sgmk/FM-1-Parametric-Vintage-Case-for-Lasercutting/docs/ACOUSTICS_AND_RESONATOR_PLAN.md

# Acoustic & Sub-Bass Resonator Guide — M-VAVE FM-1 Vintage Case

> **How this guide is organized:**
> * **This document (`ACOUSTICS_AND_RESONATOR_PLAN.md`)** is a **clear, visual guide** explaining how the speakers, clamps, and resonators work, covering our recommended build (**Aperiodic Variovent + 3D Spider Bridge Clamp**) as well as the tuned Helmholtz bass-reflex option.
> * **Want the hard-hitting peer-review engineering audit & hackerspace debate?**
>   👉 Read [**`PEER_REVIEW_DIALOGUE_SYNTH_GEEK_VS_SOUND_ENG.md`**](PEER_REVIEW_DIALOGUE_SYNTH_GEEK_VS_SOUND_ENG.md) — Dr. Viktor Vance ("The Baffle Butcher") vs Maker/Synth Geek on parasitic leaks, acoustic inertance, and mechanical clamping.
> * **Want the full story & workbench listening tests in magazine format?**
>   👉 Read [**`SYNTH_JOURNALIST_EDITORIAL_OVERVIEW.md`**](SYNTH_JOURNALIST_EDITORIAL_OVERVIEW.md) — Sound On Sound / CDM style deep-dive feature article.
> * **Want the full raw math, Thiele-Small tables, differential equations, and nomographs?**
>   👉 Jump to [**`ACOUSTICS_DEEP_ENGINEERING_ANALYSIS.md`**](ACOUSTICS_DEEP_ENGINEERING_ANALYSIS.md).

| Chosen Speaker: AliExpress `40 × 22 mm` (`4Ω 5W`) | Alternative Big Speaker: `50 × 31 mm` (`Ø45 mm` Magnet) | 4-Panel Acoustic Audit & Spider Clamp Map |
| :---: | :---: | :---: |
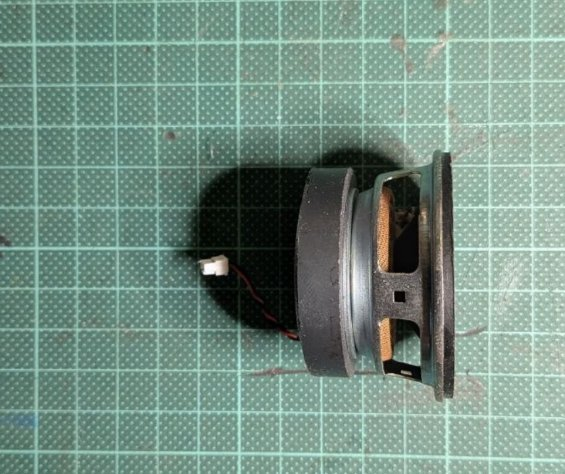
[picture p22: photos/speaker_50mm_side.jpg]
50mm Speaker Side Profile
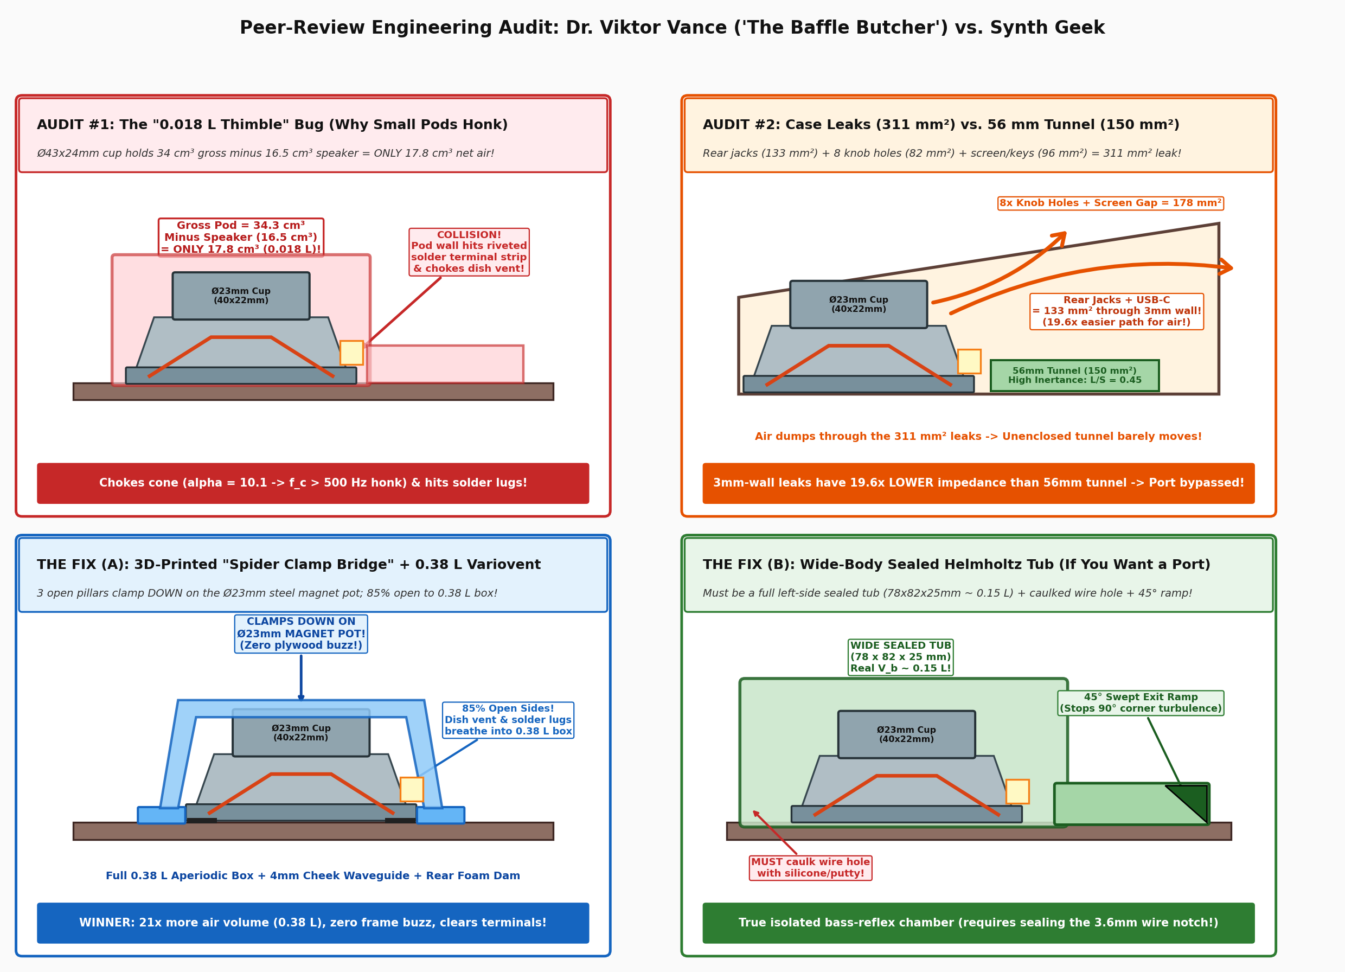
[picture p23: docs/acoustics/viktor_audit_and_spider_clamp.png]
Acoustic Audit & Spider Clamp
| 40mm AliExpress Speaker |  |  |

---

## 1. Recommended Setup: Full-Case Aperiodic Variovent + Downward Clamping

Following the critical peer-review audit by Dr. Viktor Vance, our primary recommended build (`highVintage` preset in [`fm1_lasercut_case.scad`](../fm1_lasercut_case.scad)) uses:
* **Speaker:** **AliExpress `40 × 22 mm` (`4Ω 5W`, `Ø23 mm` shielded steel cup)** mounted face-down on the Bottom Panel at **`[X = 38 mm, Y = 64 mm]`** over the curved pinwheel grille with a `1.5 mm` EVA foam sealing gasket.
* **Acoustic Enclosure Principle:** **Aperiodic Variovent (`~0.38 L` Sub-PCB Cavity).**
  * Rather than fighting the unavoidable `~311 mm²` of parasitic case leaks (jacks, USB-C, power slider, encoder shafts), we turn the entire interior into an **aperiodic damped flow enclosure**.
  * By placing a loose `2–3g` pinch of polyfill or felt around the speaker inside the case, the system acts as a mechanical-acoustic damper, achieving **$Q_{tc} \approx 0.68$**. This delivers flat, punchy, uncolored synth bass down to **`~125 Hz`**, eliminates cone bottoming/unloading on sub-audio FM clicks, and has **zero port wind noise (chuffing)**.
* **Mechanical Clamping:** To prevent plywood buzz at the full `1.35 W` amplifier output, the speaker must be held down under mechanical compression, not just located by a loose ring.

### Four Ways to Build It in OpenSCAD (`resonator_type` Dropdown)
Selectable right in [`fm1_lasercut_case.scad`](../fm1_lasercut_case.scad) under `/* [Speaker & Acoustic Grille] */`:

| Build Method | `resonator_type` Setting | How to Export & Assemble |
| :--- | :--- | :--- |
| **Option 1 (100% Laser-Cut Bass-Reflex): Stacked Wood Helmholtz Tunnel** | `"helmholtz_laser_duct"` *(Default)* | 1. Set `resonator_type = "helmholtz_laser_duct"` and `part_to_show = "layout"`.<br>2. Automatically adds the 3 wooden resonator pieces to the laser sheet (**2× Tunnel Wall Layers** + **1× Tunnel Roof Plate**).<br>3. Bottom plate gets the exit vent! Glue the layers together onto the inside of the Bottom Panel. (Export standalone via `part_to_show = "helmholtz_laser"`). |
| **Option 2 (3D-Printed Sealed Bass-Reflex): Wide-Body Sealed Tub + $45^\circ$ Ramp** | `"helmholtz_3d_pod"` | 1. Set `resonator_type = "helmholtz_3d_pod"` and `part_to_show = "helmholtz_pod"` → **Export as STL**.<br>2. A wide-body sealed chamber ($V_b \approx 0.15\,\text{L}$) with terminal relief pockets and a $45^\circ$ deflector ramp out the bottom panel.<br>3. Must be sealed airtight to the bottom plate using silicone or closed-cell foam tape! |
| **Option 3 (100% Laser-Cut Clamped Retainer): 2-Layer Stepped Wood Clamp** | `"stepped_clamp_laser"` | 1. Set `resonator_type = "stepped_clamp_laser"` and `part_to_show = "layout"`.<br>2. Cut the two stacked wooden rings: **Layer 1** centers the $\varnothing 40.4\,\text{mm}$ rim; **Layer 2** overhangs the outer metal flange by $1.2\,\text{mm}$ with a $100^\circ$ terminal cutout.<br>3. Screw or glue down to clamp the outer flange against the bottom gasket. (Export standalone via `part_to_show = "stepped_clamp"`). |
| **Option 4 (3D-Printed Bridge Clamp): 3-Pillar Spider Clamp Bridge** | `"spider_clamp_3d"` | 1. Set `part_to_show = "spider_clamp"` → **Export as STL** and 3D-print in PETG or PLA.<br>2. Fits over the `40 mm` driver with an open 3-pillar bridge, clearing the fragile side solder terminals by $100^\circ$.<br>3. Fasten down with 3× M2.5 wood screws to press down on the $\varnothing 23\,\text{mm}$ magnet pot with an EVA foam cushion. |

---

## 2. Beginner's Visual Guide: How Speakers & Sub-Bass Resonators Work

Why do we need a sealed ring, a Helmholtz tunnel, or a passive radiator in the first place? Look at the 4 panels below:

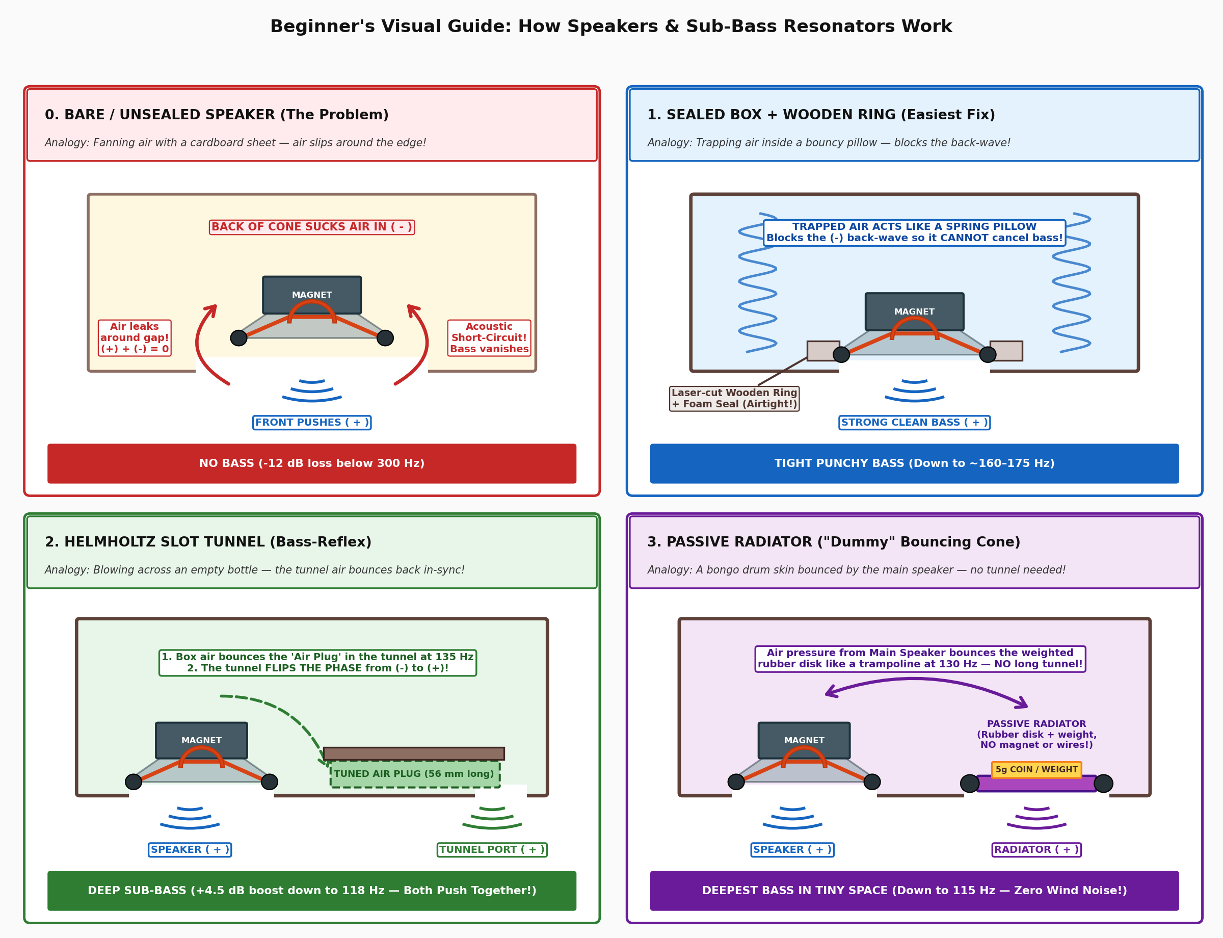
[picture p24: docs/acoustics/beginner_resonators_explained.png]
Beginner's Visual Guide: How Speakers & Sub-Bass Resonators Work


### Panel 0: Bare / Unsealed Speaker ("Acoustic Short-Circuit" — Why Bass Vanishes)
* **Analogy:** Fanning yourself with a piece of cardboard that has a hole in the middle — air just slips around the edge instead of blowing forward.
* **What happens:** When the speaker cone pushes down (`+`), the back of the cone sucks air in (`-`). If the speaker rim isn't sealed to the bottom panel, that `-` suction wave loops around the rim and cancels the `+` wave (`+` meets `-` = **zero bass below `300 Hz`**).
* *(Formula & graph: [Deep Analysis §3.1 — Acoustic Dipole Short-Circuit](ACOUSTICS_DEEP_ENGINEERING_ANALYSIS.md#31-acoustic-dipole-short-circuit-unbaffled-driver)).*

### Panel 1: Sealed Box + Wooden Ring ("The Bouncy Air Pillow" — Easiest Fix)
* **Analogy:** Putting your thumb over the nozzle of a bicycle pump — the trapped air acts like a springy cushion.
* **What happens:** Gluing the laser-cut wooden ring (`resonator_type = "retainer_ring"`) + thin foam tape around the speaker rim traps the `-` back-wave inside the box so it **cannot** leak out and cancel your bass.
* **Result:** Tight, punchy synth bass down to **`~160–175 Hz`**, boosting bass by **`+10 to +14 dB`** over an unsealed speaker.
* **Two Levels of "Simple Sealed Box" Inside Our FM-1 Case:**

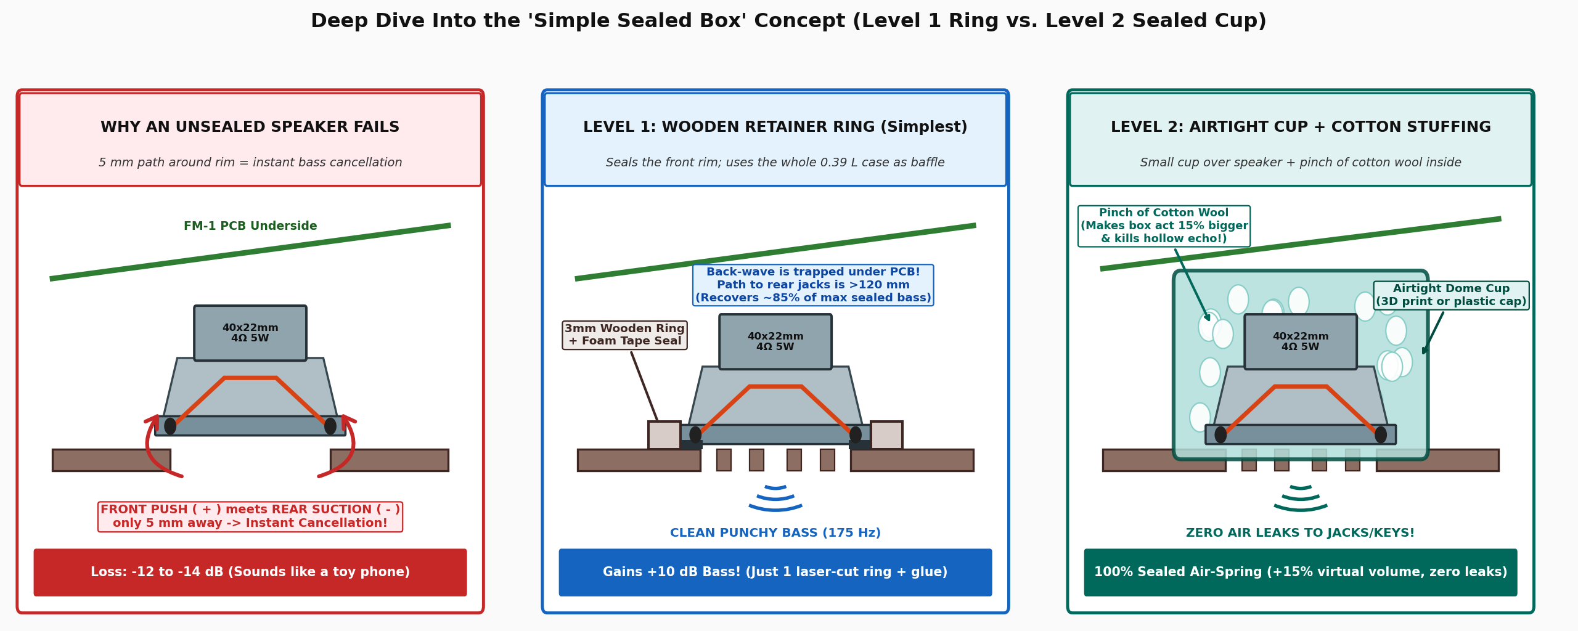
[picture p25: docs/acoustics/sealed_box_explained_detail.png]
Deep Dive Into the Simple Sealed Box Concept


  1. **Level 1 — Just the Laser-Cut Wooden Ring (`resonator_type = "retainer_ring"`):**
     * Seals the **front rim** of the speaker to the Bottom Panel, while using the **entire `0.39 L` wooden case** under the PCB as the rear chamber.
     * Even though the outer wooden case isn't 100% airtight (air can slowly breathe out through the rear USB-C/Audio jack cutouts or silicone button gaps `120 mm` away), sealing the front rim stretches the cancellation path from `5 mm` to `>120 mm` — recovering **`~85%` of the bass (`+10 dB`)** with just 1 laser-cut ring!
     * **Bonus with the AliExpress `40 × 22 mm` speaker:** Its galvanized steel basket is shaped like a semi-enclosed dish shroud with only a narrow felt-damped ring vent, so it already acts like a partially self-enclosed driver!
  2. **Level 2 — True 100% Airtight Cup + Cotton Stuffing:**
     * Instead of trying to caulk every wooden finger-joint and jack hole of the whole synth case, you glue a small **`Ø48 × 25 mm` airtight cup** (3D-printed dome, or even a plastic pill bottle cap / PVC end-cap) right over the back of the speaker on the Bottom Panel.
     * **The Cotton Wool Trick:** Loosely placing a **fluffy pinch of cotton wool or pillow stuffing (`~1 gram`)** inside that cup slows down the air molecules and absorbs heat as the air compresses, making the speaker think the cup is **`15–20%` larger** than it physically is while killing hollow plastic midrange echoes!
* *(Formula & graph: [Deep Analysis §3.2 — Closed-Box Transfer Function](ACOUSTICS_DEEP_ENGINEERING_ANALYSIS.md#32-closed-box-sealed-air-suspension-transfer-function)).*

### Panel 2: Helmholtz Slot Tunnel ("Blowing Across a Bottle" — Our Chosen Build!)
* **Analogy:** Blowing across the top of an empty glass bottle to make a loud, deep `"WHOOOO"` bass note.
* **What happens:** The air inside the speaker chamber acts like a **spring**, and the `56 mm` plug of air sitting inside the narrow `25 × 6 mm` tunnel acts like a **weight**. When the speaker plays bass notes around **`135 Hz`**, the plug of air in the tunnel bounces wildly and **flips the phase of the rear wave from `(-)` to `(+)`**!
* **Result:** Both the speaker cone AND the tunnel exit port push `+` air out of the bottom panel at the same time — adding **`+4.5 dB` of sub-bass** and extending low notes down to **`118 Hz`**.
* *(Formula & nomograph: [Deep Analysis §4 — Helmholtz Port Derivations](ACOUSTICS_DEEP_ENGINEERING_ANALYSIS.md#4-helmholtz-bass-reflex-port-derivations--tuning-nomograph)).*

### Panel 3: Passive Radiator ("The Sympathetic Bongo Drum" — No Tunnel Needed)
* **Analogy:** A sealed drum with two skins — hitting Skin #1 uses internal air pressure to bounce Skin #2 automatically.
* **What happens:** Instead of a `56 mm` air tunnel, you mount a **flat weighted rubber membrane** (a `Ø40 mm` speaker cone with a `5g` coin/washer weight and **no magnet or wires**) in the empty **Rear-Right spot (`[X=126, Y=68]`)** behind the battery. The main speaker's air pressure bounces that rubber disk at `130 Hz` in-sync (`+` + `+`).
* **Result:** Reaches **`115 Hz`** with **zero tunnel space** and **zero wind noise**.
* *(Formula & schematic: [Deep Analysis §7.2 — Hybrid Concept 3](ACOUSTICS_DEEP_ENGINEERING_ANALYSIS.md#72-hybrid-3d-printed--laser-cut-concepts)).*

### Where Each Option Fits on the FM-1 Bottom Panel
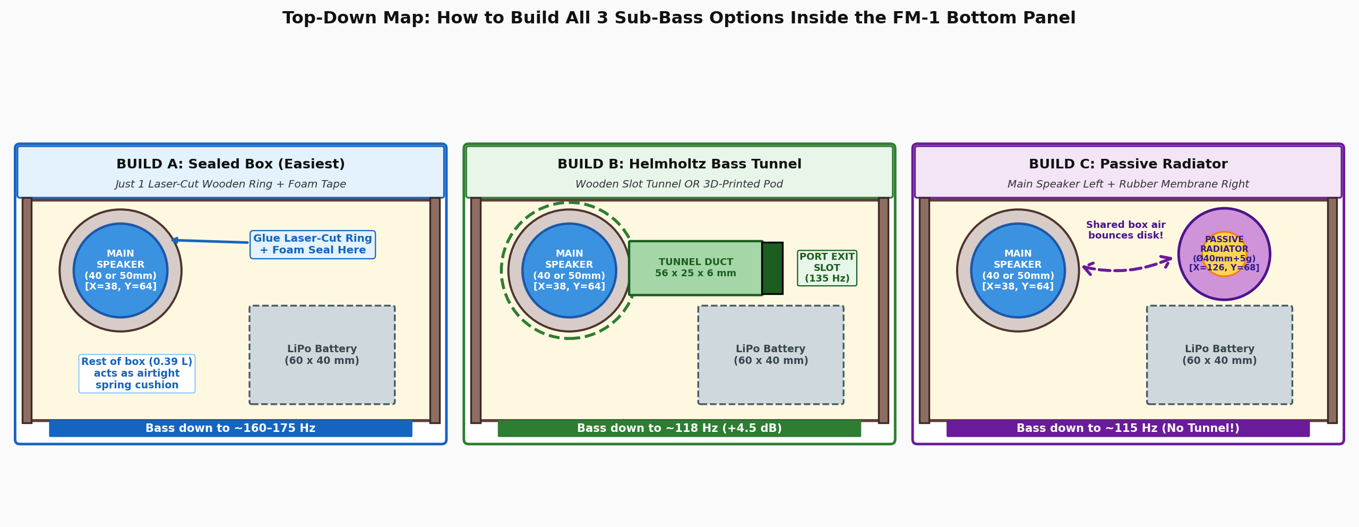
[picture p26: docs/acoustics/beginner_3_builds_inside_fm1.png]
Top-Down Map: How to Build All 3 Sub-Bass Options Inside the FM-1 Bottom Panel


---

## 3. How the Wooden Case Shape & "Cheek Tunnel" Boost the Sound

Our case (`170 × 98.4 mm`, tilted at **`12°`**) has two built-in acoustic advantages:

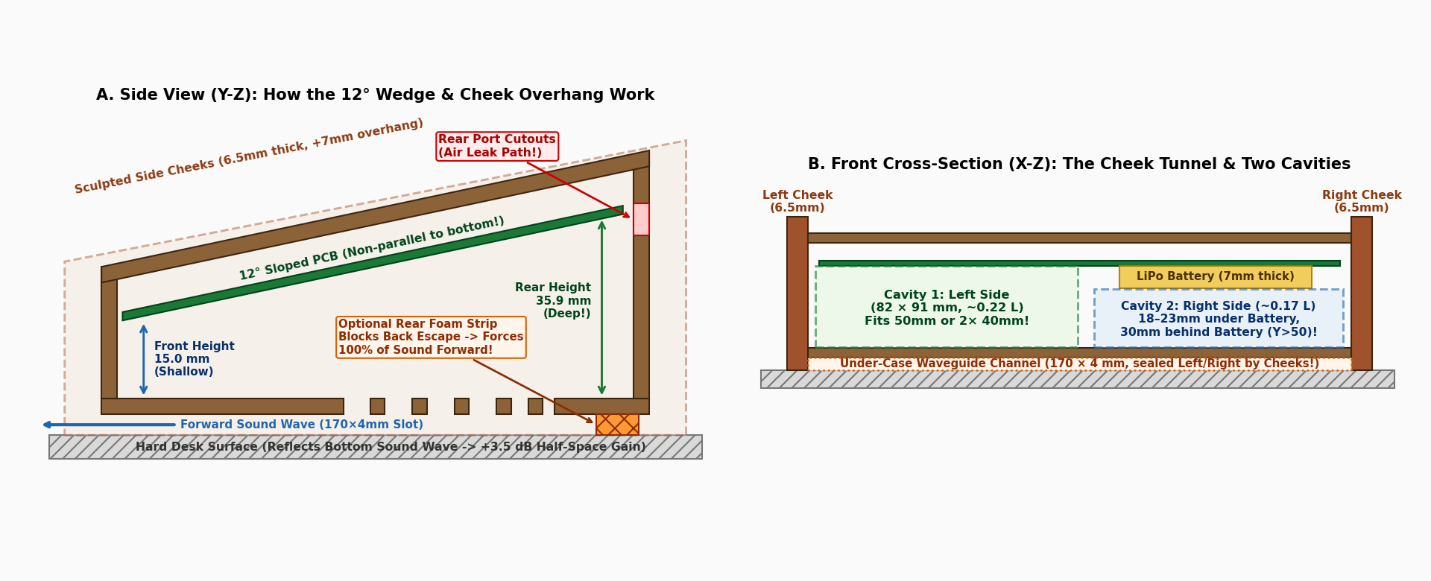
[picture p27: docs/acoustics/current_case_wedge_acoustics.png]
Current Case Wedge & Cheek Tunnel Acoustics


1. **The `12°` Tilted Wedge Stops "Boxy" Echoes:**
   * Inside the case, the space under the PCB grows from `15 mm` at the front keys to `35.9 mm` at the back knobs. Because the PCB and Bottom Panel are **not parallel**, midrange sound waves bounce diagonally instead of slapping straight up and down.
2. **Two Empty Rear Pockets (`[38, 64]` & `[126, 68]`):**
   * The `60 × 40 mm` LiPo battery sits on the front-right, leaving **two `30 mm` deep pockets at the back**: **Rear-Left (`[38, 64]`)** for our main speaker, and **Rear-Right (`[126, 68]`, behind the battery)** for our Helmholtz tunnel exit (or a second speaker / passive radiator).
3. **The 10-Second "Cheek Tunnel" Megaphone Trick:**
   * The left and right wooden side cheeks lift the Bottom Panel **`4.0 mm` off the table**, forming a `170 × 4 mm` tunnel under the synth.
   * **Do this on every build:** Stick a **`170 × 8 × 4 mm` strip of foam or wood** along the **rear bottom edge** between the two cheeks (orange block in Figure A above). That blocks sound from escaping out the back and bounces **100% of the speaker + Helmholtz port sound forward toward your ears**!
   * *(Full geometry math: [Deep Analysis §1 — Enclosure Geometry & Boundary-Waveguide Physics](ACOUSTICS_DEEP_ENGINEERING_ANALYSIS.md#1-enclosure-geometry--boundary-waveguide-physics-12-wedge--cheek-tunnel)).*

---

## 4. Other Ideas Worth Knowing (50mm Speaker, Dual Speakers & 2-Way Tweeter)

If you ever want to experiment beyond the single `40 × 22 mm` + Helmholtz setup, here are the key findings from our engineering analysis:

| Idea | How It Works | What You Need to Know | Deep Analysis Link |
| :--- | :--- | :--- | :---: |
| **1. Using Your Bigger `50 × 31 mm` Speaker** | Moves `3.3×` more air than stock (`12.6 cm²` cone), deepest natural bass ($f_s \approx 145\,\text{Hz}$). | At `31 mm` tall, it is `2 mm` too tall for the `25 mm` case at `[38, 64]`. Either set `case_internal_height = 29` in OpenSCAD, **OR** set `speaker_z_offset = -3` with `speaker_grille_style = "open_hole"` so it drops `3 mm` into the bottom panel. | [Deep Analysis §2](ACOUSTICS_DEEP_ENGINEERING_ANALYSIS.md#2-driver-specifications-measured-vs-estimated-thiele-small-parameters) & [§6](ACOUSTICS_DEEP_ENGINEERING_ANALYSIS.md#6-sub-pcb-3d-obstacle-clearance-map--case-height-scaling) |
| **2. Dual `2× 40 × 22 mm` Speakers (Left + Right)** | Mounts Speaker #1 at Rear-Left `[38, 65]` and Speaker #2 at Rear-Right `[126, 68]` (behind the battery). | Two `40 mm` speakers have **$28\%$ MORE cone area (`16.1 cm²`) than a single `50 mm` speaker**, and both fit inside the slim `25 mm` case! Wire two **`8 Ω`** drivers in **parallel** (`= 4 Ω`) or two **`4 Ω`** drivers in **series** (`= 8 Ω`). | [Deep Analysis §5.1](ACOUSTICS_DEEP_ENGINEERING_ANALYSIS.md#51-mutual-acoustic-coupling-of-two-40--22-mm-drivers) |
| **3. Zero-Cost "Woofer + Tweeter" (2-Way)** | Reuses the tiny **`26.5 mm` stock FM-1 speaker** you removed! Mount it at Front-Left `[25, 21]` wired in parallel through a **`6.8 µF` capacitor**. | Bottom-firing speakers muffle high notes (`>4 kHz`) against the desk. The `6.8 µF` capacitor blocks bass from the tiny stock speaker so it acts as a dedicated **tweeter** for sparkling FM bells while your `40 mm` speaker plays the bass! | [Deep Analysis §5.2](ACOUSTICS_DEEP_ENGINEERING_ANALYSIS.md#52-first-order-capacitive-high-pass-crossover-for-stock-265-mm-tweeter) |
| **4. Four 3D-Printed Hybrid Upgrades** | 1. Airtight Pod + Flared Port (`helmholtz_3d_pod`)<br>2. `12°` Wedge Baffle Cradle for `50 mm` speaker<br>3. TPU Passive Radiator Membrane<br>4. Under-Slung Exponential Horn Plinth | All 4 cross-sections and equations are detailed in the engineering reference. | [Deep Analysis §7.2](ACOUSTICS_DEEP_ENGINEERING_ANALYSIS.md#72-hybrid-3d-printed--laser-cut-concepts) |

---

## 5. Complete Index of Engineering Diagrams & Reference Docs

* **Hard-Hitting Peer-Review Audit Dialogue:** [**`docs/PEER_REVIEW_DIALOGUE_SYNTH_GEEK_VS_SOUND_ENG.md`**](PEER_REVIEW_DIALOGUE_SYNTH_GEEK_VS_SOUND_ENG.md) — Dr. Viktor Vance ("The Baffle Butcher") vs Maker / Synth Geek.
* **Editorial Synth Journalist Overview:** [**`docs/SYNTH_JOURNALIST_EDITORIAL_OVERVIEW.md`**](SYNTH_JOURNALIST_EDITORIAL_OVERVIEW.md) — Feature article on the transformation, audit, aperiodic epiphany, and workbench listening tests.
* **Full Engineering Reference Document:** [**`docs/ACOUSTICS_DEEP_ENGINEERING_ANALYSIS.md`**](ACOUSTICS_DEEP_ENGINEERING_ANALYSIS.md) — Comprehensive derivations, Thiele-Small formulas, and acoustic boundary physics.
* **Visual Diagrams in `docs/acoustics/`:**
  1. [`viktor_audit_and_spider_clamp.png`](acoustics/viktor_audit_and_spider_clamp.png) — 4-panel visual audit diagram: Thimble pod vs real volume, parasitic case leaks vs tunnel inertance, 3D Spider Bridge Clamp, and wide-body Helmholtz tub.
  2. [`beginner_resonators_explained.png`](acoustics/beginner_resonators_explained.png) — 4-panel beginner cartoon explaining Unsealed vs. Sealed vs. Helmholtz Tunnel vs. Passive Radiator.
  3. [`beginner_3_builds_inside_fm1.png`](acoustics/beginner_3_builds_inside_fm1.png) — Top-down map of the 3 sub-bass builds inside the FM-1 bottom plate.
  4. [`current_case_wedge_acoustics.png`](acoustics/current_case_wedge_acoustics.png) — Cross-sections of the `12°` wedge enclosure, internal cavities, and under-case "cheek tunnel" + rear foam dam.
  5. [`spl_frequency_response.png`](acoustics/spl_frequency_response.png) — Calculated SPL frequency response (dB) and cone excursion $|X(f)|$ curves.
  6. [`helmholtz_port_tuning_nomograph.png`](acoustics/helmholtz_port_tuning_nomograph.png) — Helmholtz slot port physical length $L_p$ vs. tuning frequency $f_B$ nomograph.
  7. [`pcb_underside_clearance_map.png`](acoustics/pcb_underside_clearance_map.png) — Scale 2D + Z-clearance map of PCB underside obstacles (`J1`, `J13`, LiPo battery, encoder pins).
  8. [`multi_speaker_layouts_and_spl.png`](acoustics/multi_speaker_layouts_and_spl.png) — Multi-speaker placement zones (`[38, 65]`, `[126, 68]`, `[25, 21]`) and `2× 40mm` / 2-Way SPL curves.
  9. [`resonator_cross_sections.png`](acoustics/resonator_cross_sections.png) — 3 pure laser-cut plywood architectures.
  10. [`3d_printed_hybrid_concepts.png`](acoustics/3d_printed_hybrid_concepts.png) — 4 hybrid 3D-printed sub-enclosure, wedge cradle, passive radiator, and horn plinth concepts.
