sgmk/FM-1-Parametric-Vintage-Case-for-Lasercutting/docs/acoustics/helmholtz_port_aligned_bottom_view.png

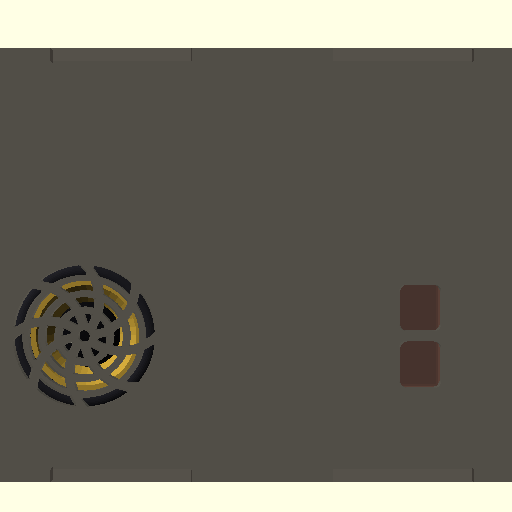
docs/acoustics/helmholtz_port_aligned_bottom_view.png
