sgmk/FM-1-Parametric-Vintage-Case-for-Lasercutting/downloaded/official_cuvave/fm-1-6.webp

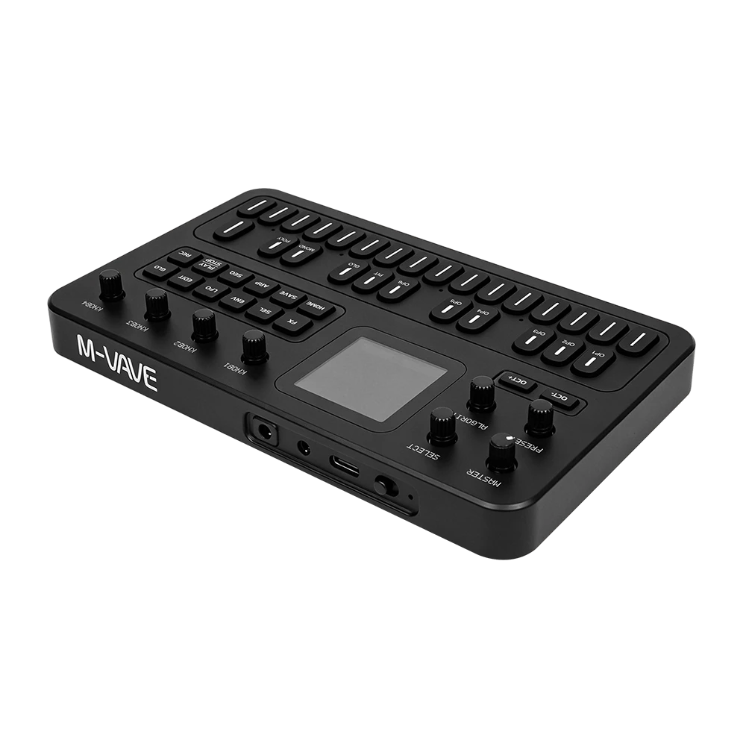
downloaded/official_cuvave/fm-1-6.webp
