sgmk/FM-1-Parametric-Vintage-Case-for-Lasercutting/photos/backside_plugs_on-off.jpg

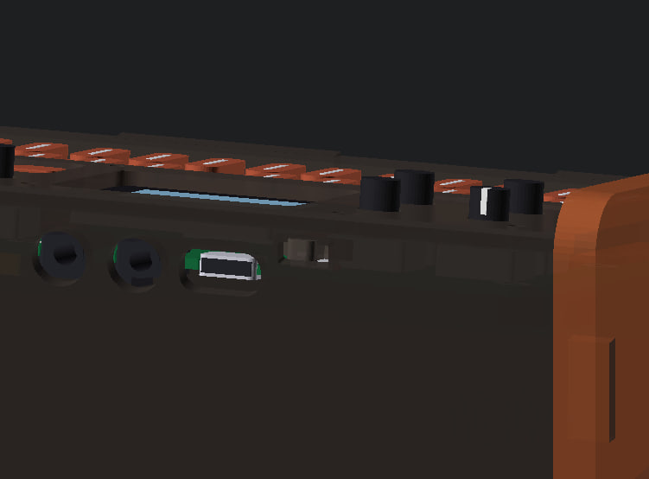
photos/backside_plugs_on-off.jpg
