sgmk/FM-1-Parametric-Vintage-Case-for-Lasercutting/photos/first_protopyecase_side.jpg

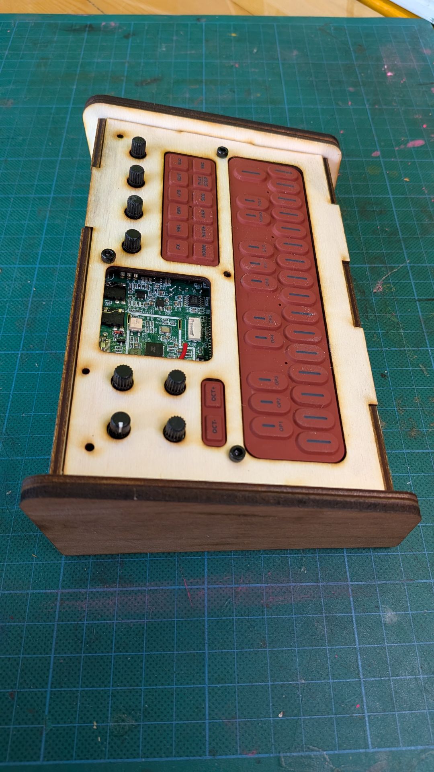
photos/first_protopyecase_side.jpg
