sgmk/FM-1-Parametric-Vintage-Case-for-Lasercutting/photos/first_prototype_case_FM-1.jpg

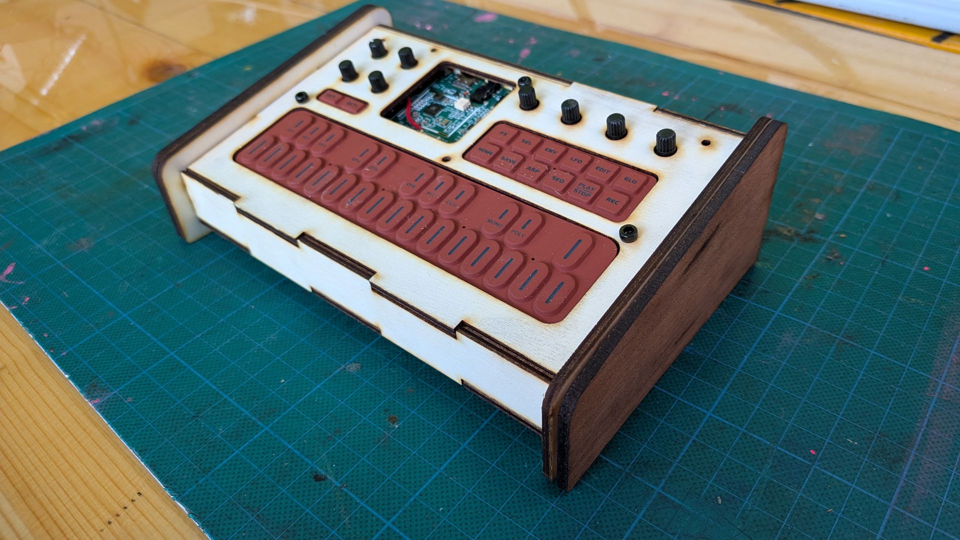
photos/first_prototype_case_FM-1.jpg
