sgmk/FM-1-Parametric-Vintage-Case-for-Lasercutting/photos/fm-1_case_front.jpg

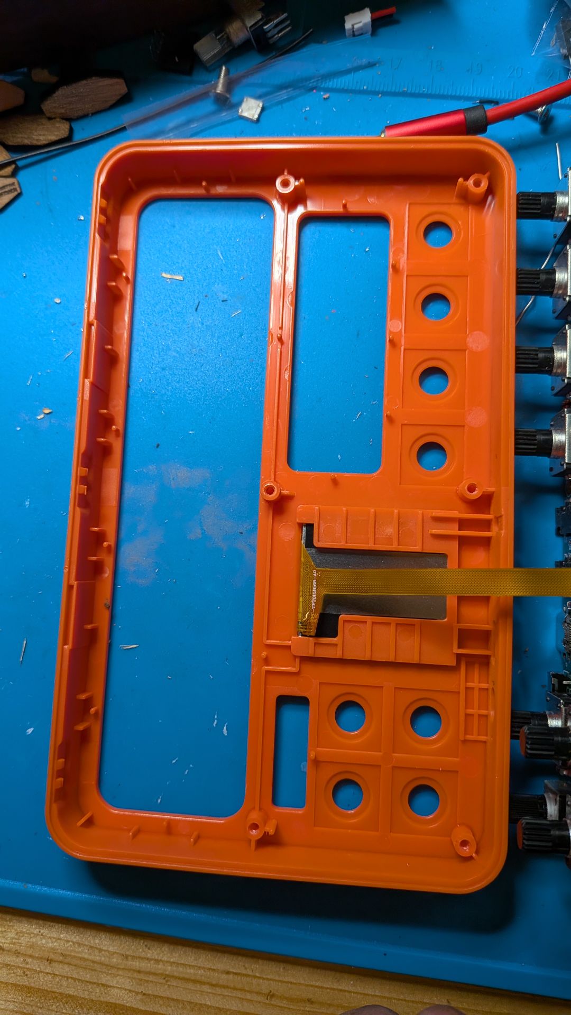
photos/fm-1_case_front.jpg
