sgmk/FM-1-Parametric-Vintage-Case-for-Lasercutting/photos/original_speaker_grille.jpg

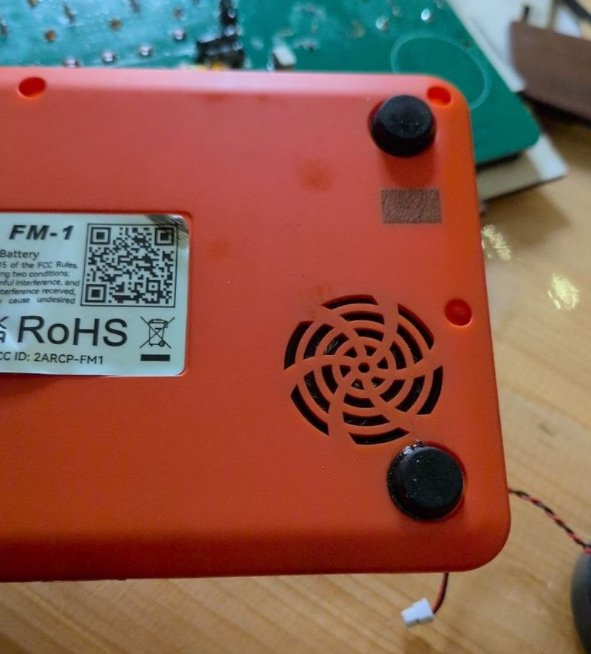
photos/original_speaker_grille.jpg
