sgmk/FM-1-Parametric-Vintage-Case-for-Lasercutting/photos/speaker_40mm_back_terminals.jpg

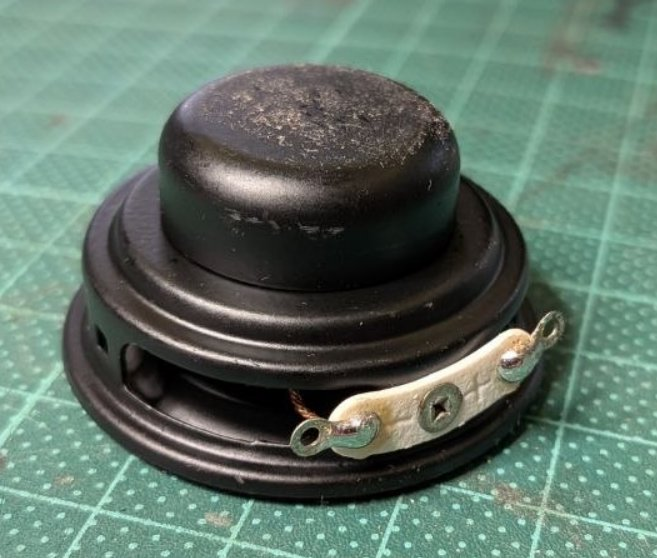
photos/speaker_40mm_back_terminals.jpg
