sgmk/FM-1-Parametric-Vintage-Case-for-Lasercutting/photos/speaker_40mm_front_mat.jpg

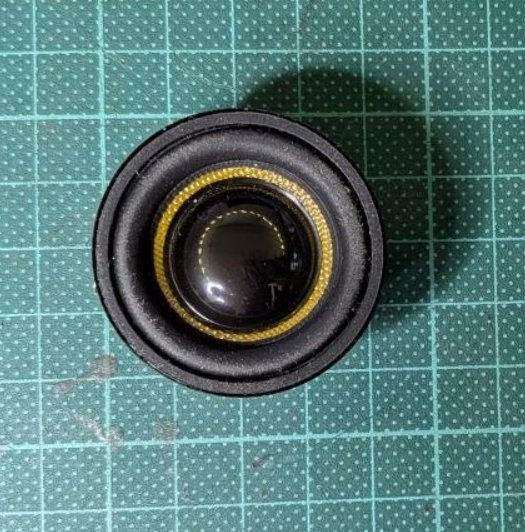
photos/speaker_40mm_front_mat.jpg
