sgmk/FM-1-Parametric-Vintage-Case-for-Lasercutting/photos/speaker_40mm_side_basket.jpg

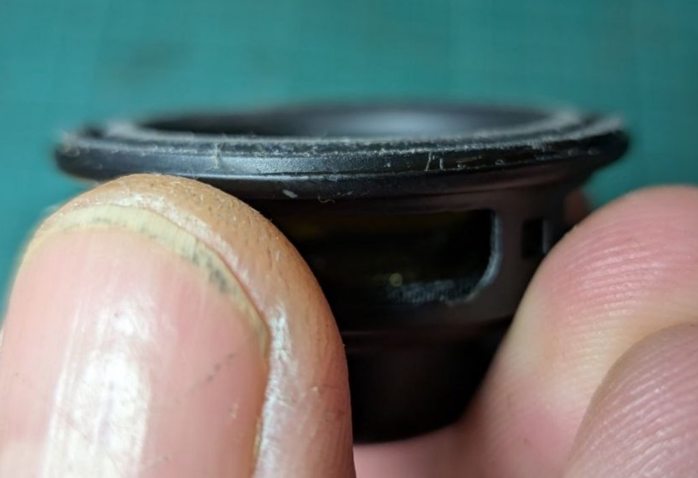
photos/speaker_40mm_side_basket.jpg
