sgmk/FM-1-Parametric-Vintage-Case-for-Lasercutting/photos/speaker_50mm_3q.jpg

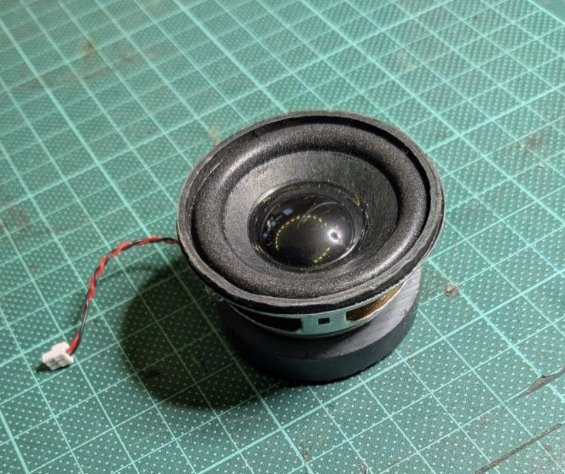
photos/speaker_50mm_3q.jpg
