sgmk/FM-1-Parametric-Vintage-Case-for-Lasercutting/docs/acoustics/helmholtz_laser_4layers_assembly.png

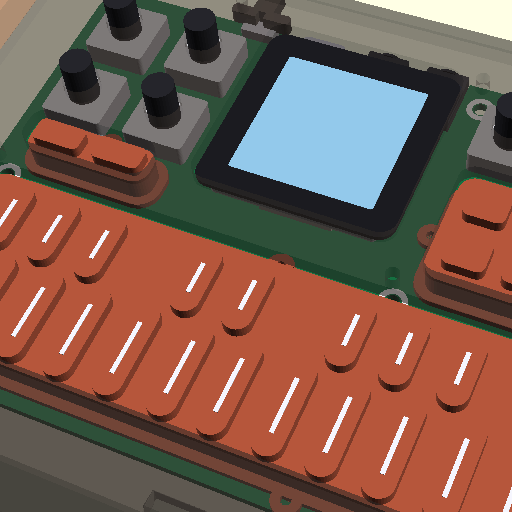
docs/acoustics/helmholtz_laser_4layers_assembly.png
