sgmk/FM-1-Parametric-Vintage-Case-for-Lasercutting/(commit log)

2026-11-06 feat: parametric vintage laser-cut case and 3D hardware model for M-VAVE FM-1
    [fm1_lasercut_case.scad, fm1_pcb_and_silicone.scad]
2026-11-09 Add 40mm & 50mm 3D speaker models, pinwheel grille, 135Hz Helmholtz resonators, and acoustic guides
    [fm1_lasercut_case.scad, fm1_pcb_and_silicone.scad]
2026-11-10 agentic review in progress
    [fm1_lasercut_case.scad]
2026-11-10 Add synth journalist editorial, acoustic audit updates, and spider clamp mounting models
    [fm1_lasercut_case.scad]
2026-11-10 Streamline speaker and resonator options, eliminate redundant sliders and legacy toggles
    [fm1_lasercut_case.scad]
2026-11-10 Restore laser-cut Helmholtz resonator option and clarify resonator naming
    [fm1_lasercut_case.scad]
2026-11-10 Calibrate 40mm speaker dimensions, add 36.8mm glued spacer well, and fix Helmholtz port slot alignment
    [fm1_lasercut_case.scad, fm1_pcb_and_silicone.scad]
2026-11-10 Update laser-cut Helmholtz duct to 4-layer stack: 36.8mm spacer, 6mm low tunnel, and 23.5mm magnet pot seal collar
    [fm1_lasercut_case.scad]
2026-11-10 Shrink wire notch to 4.5mm slot and add stacked collar rings above closed tunnel to seal 23mm magnet pot
    [fm1_lasercut_case.scad]
2026-11-10 Reinforce laser-cut power switch slider: 5.2mm deep reach, 5.5mm beefy fork arms, solid spine, 9mm back slot
    [fm1_lasercut_case.scad]
2026-11-10 Add dedicated 3D view of speaker and helmholtz duct (helmholtz_3d & helmholtz_3d_exploded), widen Layer 3 to 40.5mm, and update stack to 7 layers (21mm)
    [fm1_lasercut_case.scad]
2026-11-10 Add 22mm x 3.5mm solder latch relief pocket and wire pass-through slot to Layers 2, 3, and 4
    [fm1_lasercut_case.scad]
2026-11-10 Resize solder latch notch: compact 9mm width x 2mm depth, preserving continuous 2.8mm outer wood hoop
    [fm1_lasercut_case.scad]
2026-11-10 Tune solder latch relief: wide (19mm) for full latch span, shallow (1.4mm into wall) leaving 3.35mm solid outer hoop
    [fm1_lasercut_case.scad]
2026-11-10 Rebuild fm1_aliexpress_40mm_speaker_3d matching physical hardware photo: stepped cylindrical tiers, sharp 38->32mm shelf, large acoustic windows, and rounded dome pot
    [fm1_pcb_and_silicone.scad]
2026-11-10 Calibrate fm1_aliexpress_40mm_speaker_3d and laser rings from user caliper measurements: Total=21mm, Pot=23.1x8.5mm, Mid=30.5x1.9mm, Cage=36x8.1mm, Rim=40x2.5mm
    [fm1_lasercut_case.scad, fm1_pcb_and_silicone.scad]
2026-11-10 Add M3 screw ear extensions to all Helmholtz laser layers and bottom panel for bolt-together assembly
    [fm1_lasercut_case.scad]
2026-11-10 Rotate ring M3 ear tabs towards backside (+Y, angles 55 and 125 deg) so they stay completely inside the case with zero front overhang
    [fm1_lasercut_case.scad]
2026-11-10 Switch Helmholtz pot M3 screw ears 90 deg to the rear of the tube (-X)
    [fm1_lasercut_case.scad]
2026-11-11 Redesign screen mount hole for bare LCD with top-mounted cover and add SVG laser engraving
    [fm1_lasercut_case.scad]
2026-11-11 Add lower PCB keyboard anti-wiggle support rail and 3D wedge with mortise tabs
    [fm1_lasercut_case.scad]
2026-11-11 Add laser-cut thin wooden screen frame and clear acrylic protector options
    [fm1_lasercut_case.scad]
2026-11-11 Organize display modes into clean sub-topics with category selector
    [fm1_lasercut_case.scad]
2026-11-11 Simplify view selection to a single grouped dropdown list
    [fm1_lasercut_case.scad]
2026-11-11 some files for laser cutting
2026-11-12 Update README with final prototype photos (screen fixed and running)
2026-11-12 Add Known Issues & Future To-Do section covering acoustics, screen removal, and 3D printed fork
2026-11-12 Add acoustic engineering summary chapter with driver and resonator stack photos
